Sithminii/Analog_ECG_Monitor/README.md

# Overview
Me and my two other friends were able to design an ECG monitor only using analog components during our semester 3.
