Sithminii/Analog_ECG_Monitor/full cct.asc

C1: cap; 0.1µ
C2: polcap; 100µ; V=6.3 Irms=4.08248 Rser=0.015 Lser=0 mfg="KEMET" pn="A700D107M006ATE015" type="Al electrolytic"
C3: polcap; 100µ; V=6.3 Irms=4.08248 Rser=0.015 Lser=0 mfg="KEMET" pn="A700D107M006ATE015" type="Al electrolytic"
C4: polcap; 100µ; V=6.3 Irms=4.08248 Rser=0.015 Lser=0 mfg="KEMET" pn="A700D107M006ATE015" type="Al electrolytic"
C5: cap; 0.1µ; V=6.3 Irms=0 Rser=0 Lser=0 mfg="Murata" pn="GRM011R60J103KE01" type="X5R"
C6: cap; 0.4µ
C7: cap; 0.1µ
C8: cap; 0.1µ
C9: cap; 0.3µ
C10: cap; 50n
C11: cap; 0.1µ
C12: cap; 0.1µ
R1: res; 1Meg
R2: res; 0.5Meg
R3: res; 15K
R4: res; 10K var
R5: res; 1Meg; tol=1 pwr=0.1
R6: res; 1Meg; tol=1 pwr=0.1
R7: res; 10K
R8: res; 10K
R9: res; 10K
R10: res; 10K
R11: res; 50K
R12: res; 50K
R13: res; 27K
R14: res; 10K
R15: res; 10K
R16: res; 27K
R17: res; 1K
R18: res; 5K
R19: res; 10K var
R20: res; 27K
R21: res; 10K
R22: res; 10K
R23: res; 10K
R24: res; 10K
R25: res; 5K
R26: res; 5K
R27: res; 5K
R28: res; 27K
R29: res; 1K var
R30: res; 27K
R31: res; 1K var
R32: res; 5K
R33: res; 5K
R34: res; 5K
R35: res; 15K
R36: res; 10K var
R37: res; 4K
U1: ADTL082
U2: ADTL082
U3: opamp2; LM4562
U4: opamp2; LM4562
U5: opamp2; LM4562
U6: ADTL082
U7: ADTL082
U8: ADTL082
U9: ADTL082
U10: ADTL082
U11: OP07
Named nets: 0, +Vcc, -Vcc, LL, LA, RA, out
D:\\Software\\LTspice\\lib\\sub\\LM4562.lib
.include D:\\Software\\LTspice\\lib\\sub\\LM4562.lib
Leg drive circuit
Instrumentation Amplifier
High pass filter
Low pass filter
Notch filter
